annegautham/STM-1/Electronics/Tunnelling-Amp/Tunnelling-Amp.kicad_pcb

## KiCad design Electronics/Tunnelling-Amp/Tunnelling-Amp.kicad_pcb (2025-03-03)

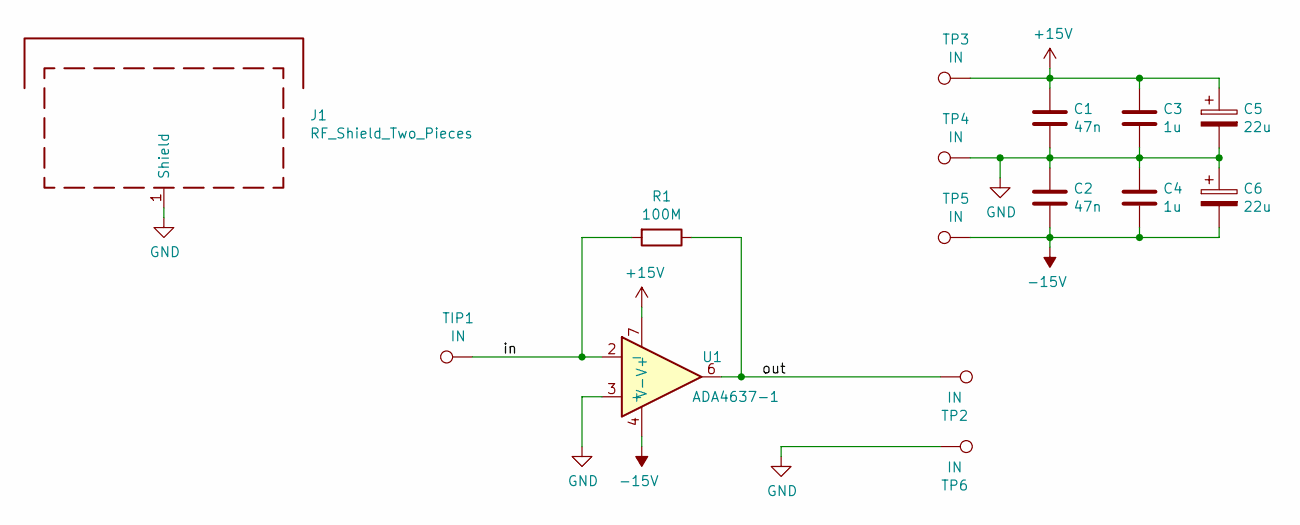
[picture p1: schematic Tunnelling-Amp.kicad_sch]

Parts:
C1, C2: 47n; C_0603_1608Metric_Pad1.05x0.95mm_HandSolder
C3, C4: 1u; C_0805_2012Metric_Pad1.15x1.40mm_HandSolder
C5, C6: 22u; CP_Elec_6.3x5.4
J1: RF_Shield_Two_Pieces; Laird_Technologies_BMI-S-101_13.66x12.70mm; Digikey 903-1006-1-ND
R1: 100M; R_1206_3216Metric_Pad1.42x1.75mm_HandSolder; Digikey 541-100MALCT-ND
TIP1: IN; TestPoint_Pad_2.5x2.5mm
TP2, TP3, TP4, TP5, TP6: IN; TestPoint_Pad_D3.0mm
U1: ADA4637-1; SOIC-8_3.9x4.9mm_P1.27mm; Digikey ADA4637-1ARZ-ND

Connections:
+15V: C1.1, C3.1, C5.1, TP3.1, U1.7 (V+)
-15V: C2.2, C4.2, C6.2, TP5.1, U1.4 (V-)
/in: R1.2, TIP1.1, U1.2 (-)
/out: R1.1, TP2.1, U1.6
GND: C1.2, C2.1, C3.2, C4.1, C5.2, C6.1, J1.1, TP4.1, TP6.1, U1.3 (+)

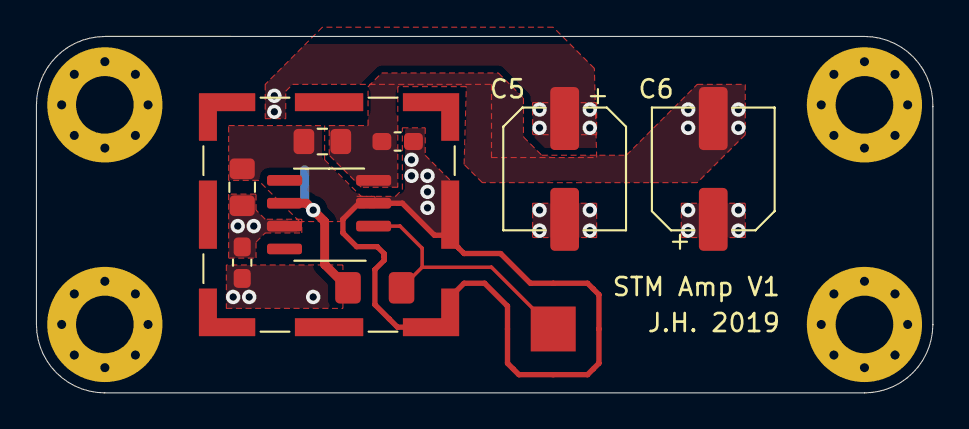
[picture p2: board Tunnelling-Amp.kicad_pcb from above]

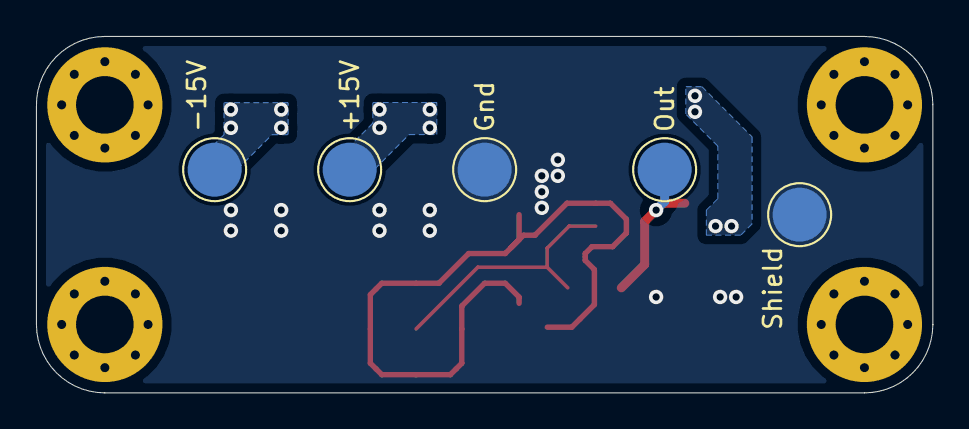
[picture p3: board Tunnelling-Amp.kicad_pcb from below]

Board: 2 copper layers, 49.8 x 19.8 mm, 15 parts (5 on the bottom side), 5 nets.
