annegautham/STM-1/Electronics/Supply-Board/Supply-Board.kicad_pcb

## KiCad design Electronics/Supply-Board/Supply-Board.kicad_pcb (2025-03-03)

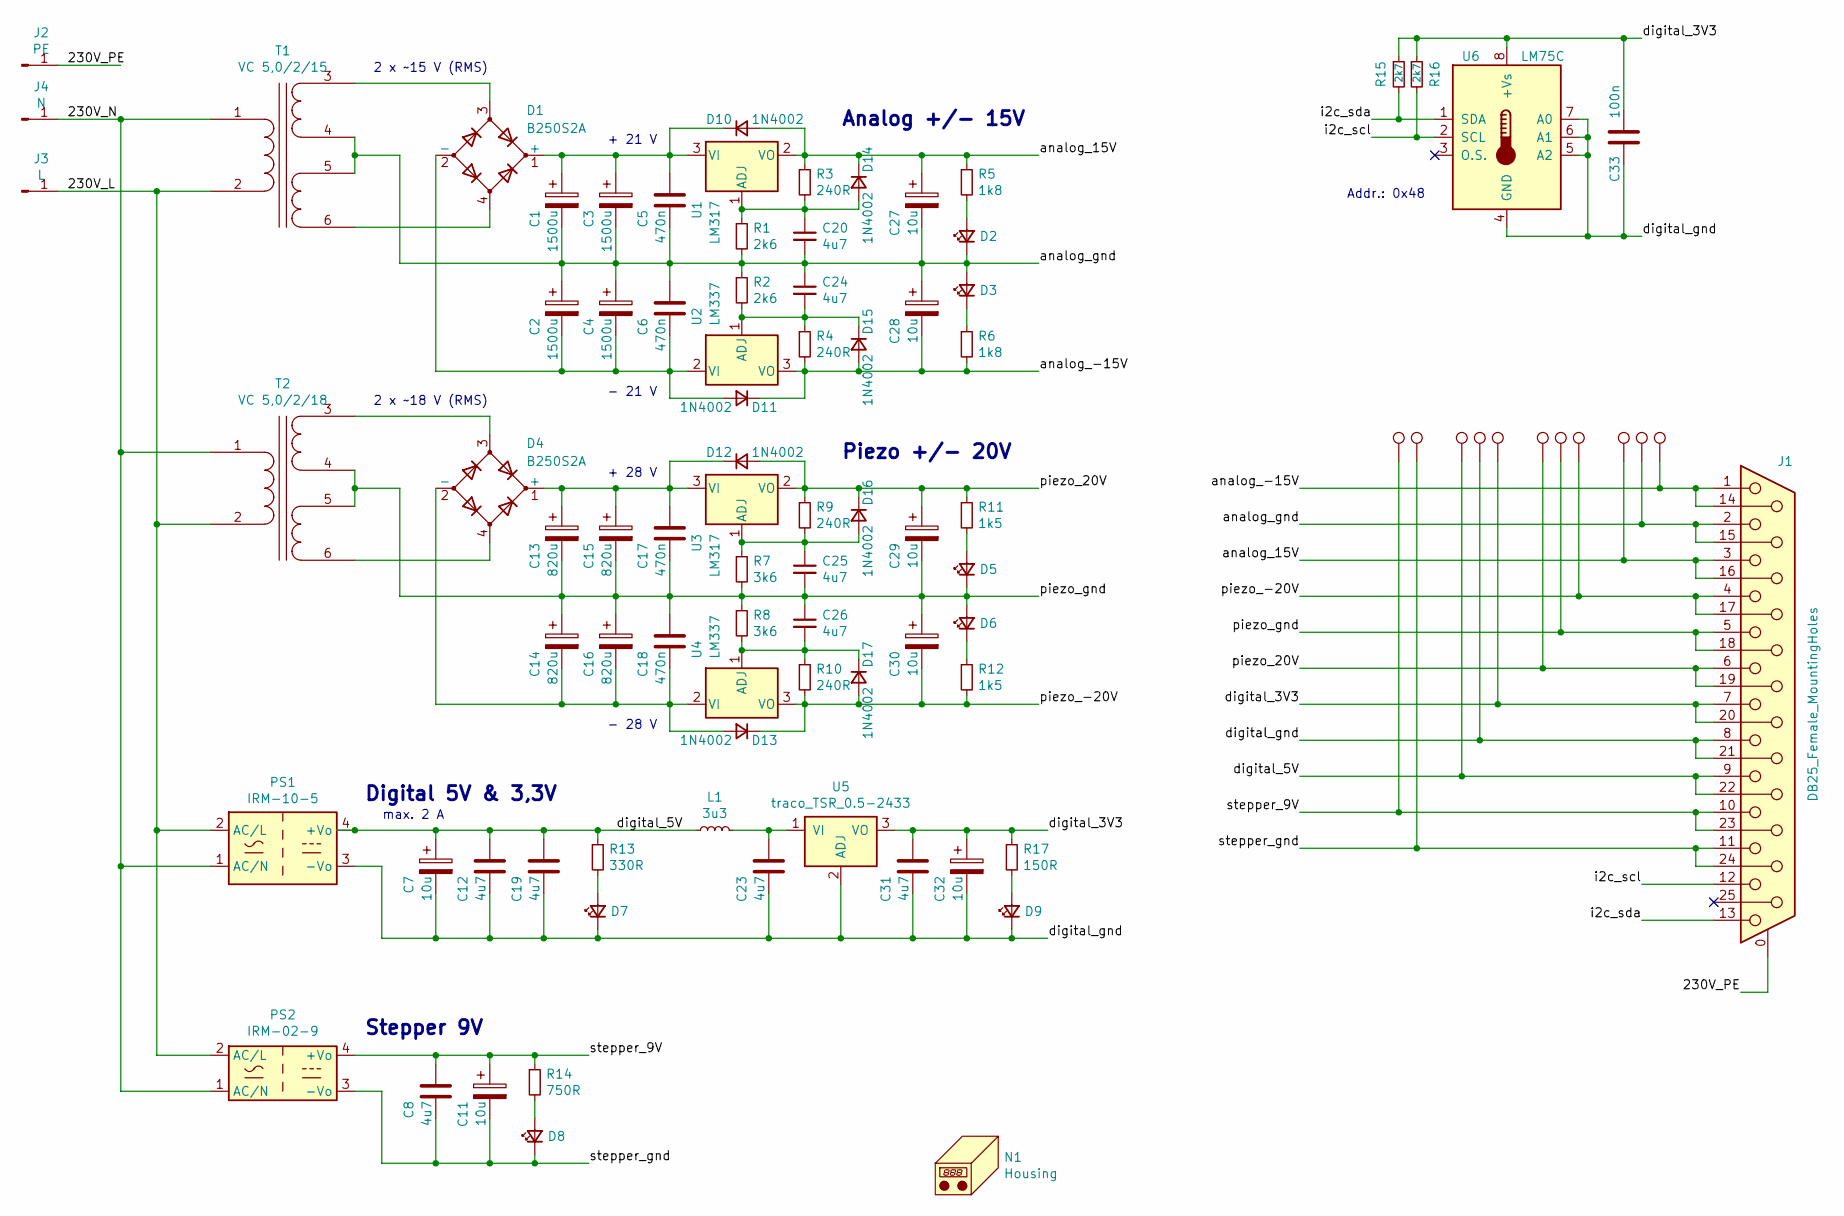
[picture p4: schematic Supply-Board.kicad_sch]

Parts:
C1, C2, C3, C4: 1500u; CP_Radial_D12.5mm_P5.00mm
C5, C6, C17, C18: 470n; C_1206_3216Metric_Pad1.42x1.75mm_HandSolder
C7, C11, C32: 10u; CP_EIA-6032-28_Kemet-C_Pad2.25x2.35mm_HandSolder
C8, C12, C19, C23, C31: 4u7; C_0805_2012Metric_Pad1.15x1.40mm_HandSolder
C13, C14, C15, C16: 820u; CP_Radial_D12.5mm_P5.00mm
C20, C24, C25, C26: 4u7; C_1206_3216Metric_Pad1.42x1.75mm_HandSolder
C27, C28, C29, C30: 10u; CP_EIA-7343-31_Kemet-D_Pad2.25x2.55mm_HandSolder
C33: 100n; C_0805_2012Metric_Pad1.15x1.40mm_HandSolder
D1, D4: B250S2A; Diode_Bridge_Diotec_SO-DIL-Slim
D2, D3, D5, D6, D7, D8, D9: LED_Small; LED_0603_1608Metric_Pad1.05x0.95mm_HandSolder
D10, D11, D12, D13, D14, D15, D16, D17: 1N4002; D_MELF
J1: DB25_Female_MountingHoles; DSUB-25_Female_Horizontal_P2.77x2.84mm_EdgePinOffset4.94mm_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
J2: PE; Pin_D1.3mm_L11.3mm_W2.8mm_Flat
J3: L; Pin_D1.3mm_L11.3mm_W2.8mm_Flat
J4: N; Pin_D1.3mm_L11.3mm_W2.8mm_Flat
L1: 3u3; L_Fastron_PISN_Handsoldering
N1: Housing; Hammond_1455N1602BK
PS1: IRM-10-5; Converter_ACDC_MeanWell_IRM-10-xx_THT
PS2: IRM-02-9; Converter_ACDC_MeanWell_IRM-02-xx_THT
R1, R2: 2k6; R_0805_2012Metric_Pad1.15x1.40mm_HandSolder
R3, R4, R9, R10: 240R; R_0805_2012Metric_Pad1.15x1.40mm_HandSolder
R5, R6: 1k8; R_0805_2012Metric_Pad1.15x1.40mm_HandSolder
R7, R8: 3k6; R_0805_2012Metric_Pad1.15x1.40mm_HandSolder
R11, R12: 1k5; R_0805_2012Metric_Pad1.15x1.40mm_HandSolder
R13: 330R; R_0805_2012Metric_Pad1.15x1.40mm_HandSolder
R14: 750R; R_0805_2012Metric_Pad1.15x1.40mm_HandSolder
R15, R16: 2k7; R_0805_2012Metric_Pad1.15x1.40mm_HandSolder
R17: 150R; R_0805_2012Metric_Pad1.15x1.40mm_HandSolder
T1: VC 5,0/2/15; Block_VC5
T2: VC 5,0/2/18; Block_VC5
TP1, TP2, TP3, TP4, TP5, TP6, TP7, TP8, TP9, TP10, TP11: TestPoint; TestPoint_Loop_D1.80mm_Drill1.0mm_Beaded
U1, U3: LM317; TO-252-2
U2, U4: LM337; TO-252-2
U5: traco_TSR_0.5-2433
U6: LM75C; SOIC-8_3.9x4.9mm_P1.27mm

Connections:
/230V_L: J3.1, PS1.2 (AC/L), PS2.2 (AC/L), T1.2 (AB), T2.2 (AB)
/230V_N: J4.1, PS1.1 (AC/N), PS2.1 (AC/N), T1.1 (AA), T2.1 (AA)
/230V_PE: J1.0 (PAD), J2.1
/analog_15V: C27.1, D10.2 (A), D14.1 (K), J1.3, J1.16, R3.1, R5.1, TP7.1, U1.2 (VO)
/analog_-15V: C28.2, D11.1 (K), D15.2 (A), J1.1, J1.14, R4.2, R6.2, TP1.1, U2.3 (VO)
/analog_gnd: C1.2, C2.1, C3.2, C4.1, C5.2, C6.1, C20.2, C24.1, C27.2, C28.1, D2.1 (K), D3.2 (A), J1.2, J1.15, R1.2, R2.1, T1.4 (SB), T1.5 (SC), TP8.1
/digital_3V3: C31.1, C32.1, C33.1, J1.7, J1.20, R15.1, R16.1, R17.1, TP3.1, U5.3 (VO), U6.8 (+Vs)
/digital_5V: C7.1, C12.1, C19.1, J1.9, J1.22, L1.1, PS1.4 (+Vo), R13.1, TP11.1
/digital_gnd: C7.2, C12.2, C19.2, C23.2, C31.2, C32.2, C33.2, D7.1 (K), D9.1 (K), J1.8, J1.21, PS1.3 (-Vo), TP2.1, U5.2 (ADJ), U6.4 (GND), U6.5 (A2), U6.6 (A1), U6.7 (A0)
/i2c_scl: J1.12, R16.2, U6.2 (SCL)
/i2c_sda: J1.13, R15.2, U6.1 (SDA)
/piezo_20V: C29.1, D12.2 (A), D16.1 (K), J1.6, J1.19, R9.1, R11.1, TP4.1, U3.2 (VO)
/piezo_-20V: C30.2, D13.1 (K), D17.2 (A), J1.4, J1.17, R10.2, R12.2, TP6.1, U4.3 (VO)
/piezo_gnd: C13.2, C14.1, C15.2, C16.1, C17.2, C18.1, C25.2, C26.1, C29.2, C30.1, D5.1 (K), D6.2 (A), J1.5, J1.18, R7.2, R8.1, T2.4 (SB), T2.5 (SC), TP5.1
/stepper_9V: C8.1, C11.1, J1.10, J1.23, PS2.4 (+Vo), R14.1, TP9.1
/stepper_gnd: C8.2, C11.2, D8.1 (K), J1.11, J1.24, PS2.3 (-Vo), TP10.1
unnamed: C1.1, C3.1, C5.1, D1.1 (+), D10.1 (K), U1.3 (VI)
unnamed: C2.2, C4.2, C6.2, D1.2 (-), D11.2 (A), U2.2 (VI)
unnamed: D2.2 (A), R5.2
unnamed: D3.1 (K), R6.1
unnamed: D5.2 (A), R11.2
unnamed: D6.1 (K), R12.1
unnamed: D7.2 (A), R13.2
unnamed: D8.2 (A), R14.2
unnamed: D9.2 (A), R17.2
unnamed: C13.1, C15.1, C17.1, D4.1 (+), D12.1 (K), U3.3 (VI)
unnamed: C14.2, C16.2, C18.2, D4.2 (-), D13.2 (A), U4.2 (VI)
unnamed: C20.1, D14.2 (A), R1.1, R3.2, U1.1 (ADJ)
unnamed: C24.2, D15.1 (K), R2.2, R4.1, U2.1 (ADJ)
unnamed: C25.1, D16.2 (A), R7.1, R9.2, U3.1 (ADJ)
unnamed: C26.2, D17.1 (K), R8.2, R10.1, U4.1 (ADJ)
unnamed: D1.3, T1.3 (SA)
unnamed: D1.4, T1.6 (SD)
unnamed: D4.3, T2.3 (SA)
unnamed: D4.4, T2.6 (SD)
unnamed: C23.1, L1.2, U5.1 (VI)

Notes on the sheet:
Piezo +/- 20V
max. 2 A
- 21 V
Stepper 9V
2 x ~18 V (RMS)
2 x ~15 V (RMS)
- 28 V
Digital 5V & 3,3V
Addr.: 0x48
+ 21 V
Analog +/- 15V
+ 28 V

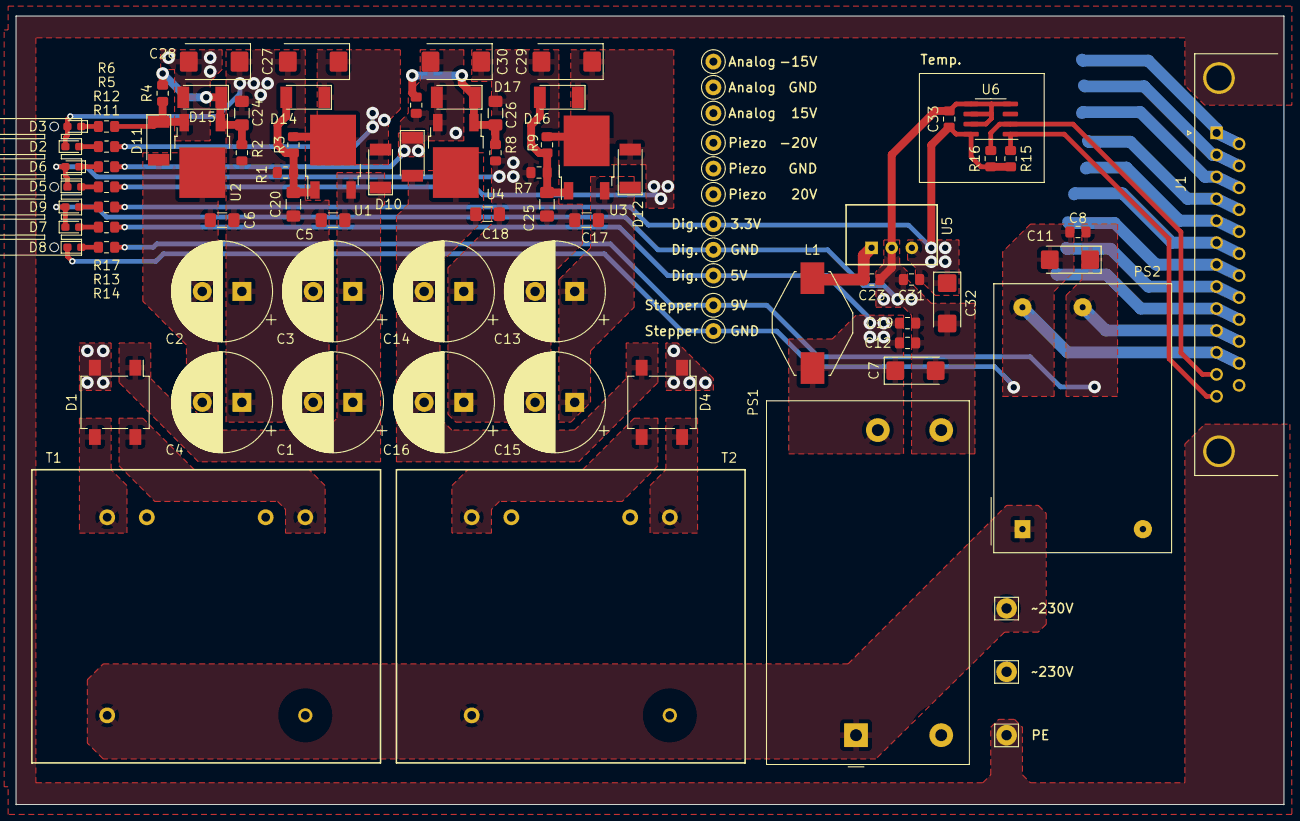
[picture p5: board Supply-Board.kicad_pcb from above]

Board: 2 copper layers, 160.0 x 99.5 mm, 91 parts (0 on the bottom side), 36 nets.

Other parts of the board:
e: light-guide
